adamvotocek/Open-Tube-Light/Code/Open-Tube-Light/DocumentationPics/20260207MPUBaseRegion0.png

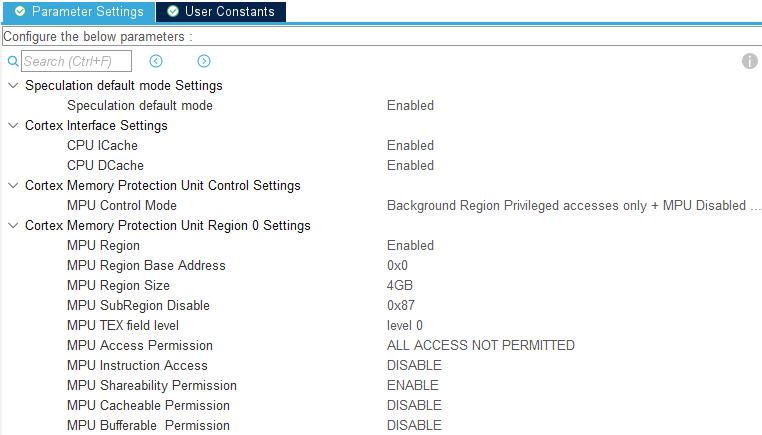
Code/Open-Tube-Light/DocumentationPics/20260207MPUBaseRegion0.png
