adamvotocek/Open-Tube-Light/PCB/ledTubeFixture/ledTubeFixture3Dmodel.step

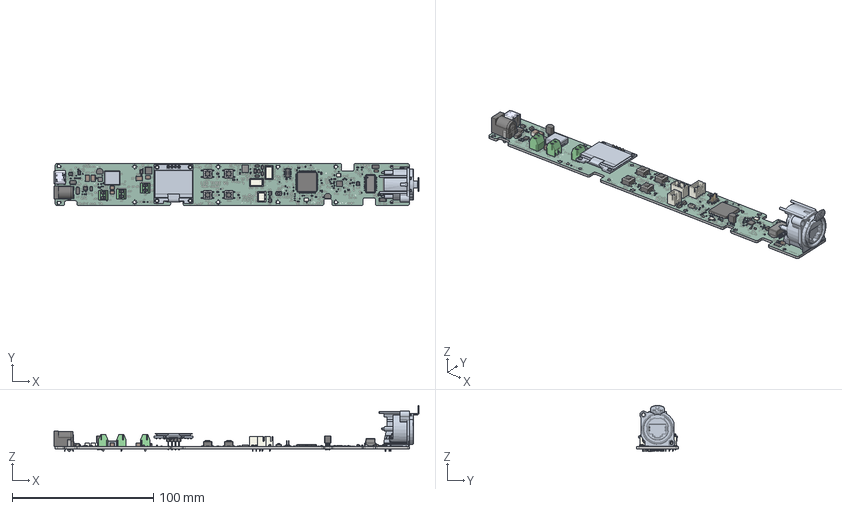
[picture p3: CAD file, 2026-05-30]
PCB/ledTubeFixture/ledTubeFixture3Dmodel.step
258.1 x 30.0 x 32.7 mm
D_SMA x 2
SOT-23-6 x 3
R_0603_1608Metric x 8
SW_SPST_PTS645Sx43SMTR92 x 4
R_0402_1005Metric x 47
C_0402_1005Metric x 45
LED_0603_1608Metric x 5
Crystal_SMD_3225-4Pin_3.2x2.5mm x 2
TO-92_Inline x 2
PT61018PEL
SOT-23-5 x 2
PinHeader_2x05_P1.27mm_Vertical_SMD
TPS56637RPAR--3DModel-STEP-56544
C_1210_3225Metric x 3
C_0603_1608Metric x 9
SW_Push_SPST_NO_Alps_SKRK
Texas_RGE0024H_VQFN-24-1EP_4x4mm_P0.5mm_EP2.7x2.7mm
L_APV_ANR5020
D_SOD-123F x 3
R_2010_5025Metric x 2
C_1812_4532Metric x 3
2445P Screw Terminal Block- 2 Pin, 3.5mm Pitch, Side Entry x 3
BarrelJack_GCT_DCJ200-10-A_Horizontal
ledTubeFixture3Dmodel 1.84.1
CA-IS2092A
JST_XH_B3B-XH-A_1x03_P2.50mm_Vertical x 2
R_1206_3216Metric x 4
JST_XH_B2B-XH-A_1x02_P2.50mm_Vertical
LQFP-100_14x14mm_P0.5mm
PDFN3333 (DFN8 3.3x3.3)
30012225_-_NE8FAH
C_1206_3216Metric x 2
TSOT-23-6
PinHeader_1x04_P2.54mm_Vertical
ledTubeFixture3Dmodel 1.167.1
ledTubeFixture_silkscreen
ledTubeFixture_soldermask x 2
ledTubeFixture_PCB
