adamvotocek/Open-Tube-Light/PCB/xlrConBoards/xlrConBoards.step

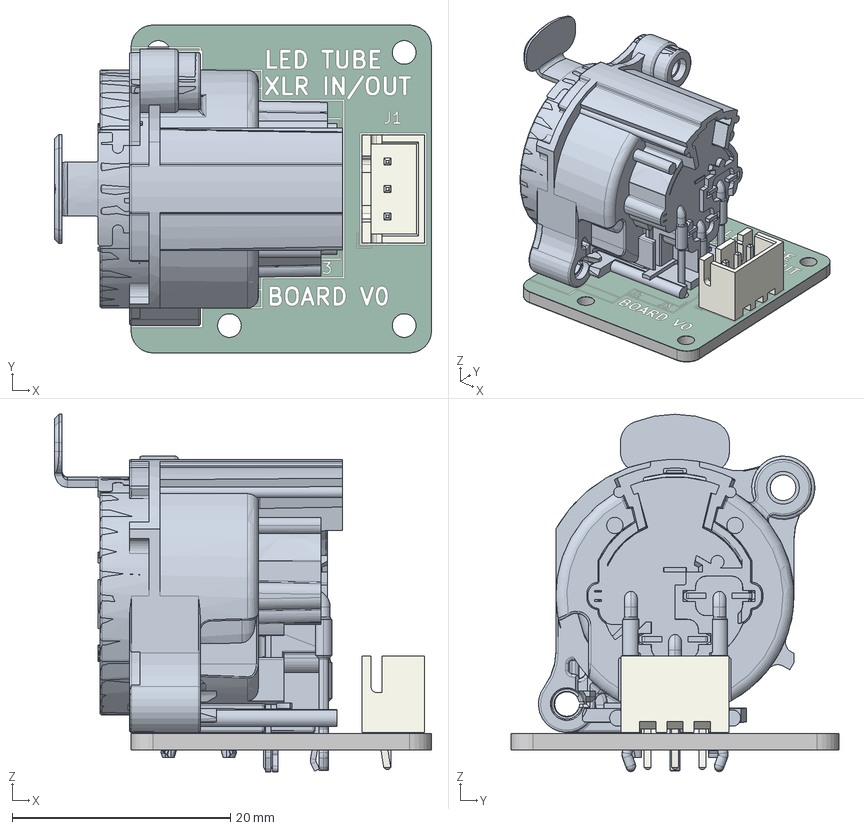
[picture p4: CAD file, 2026-05-30]
PCB/xlrConBoards/xlrConBoards.step
34.5 x 30.0 x 32.7 mm
JST_XH_B3B-XH-A_1x03_P2.50mm_Vertical
NC3FAAH
3D Model NC3MAAH-0
xlrConBoards_silkscreen
xlrConBoards_soldermask x 2
xlrConBoards_PCB
