adamvotocek/Open-Tube-Light/PCB/ledTubeFixture/ledTubeFixture.kicad_pcb

## KiCad design PCB/ledTubeFixture/ledTubeFixture.kicad_pcb (2026-11-11)

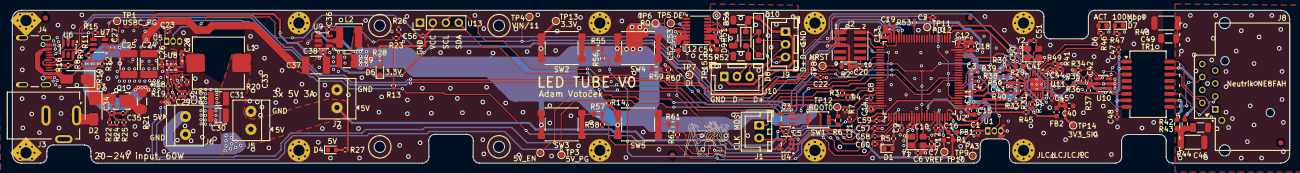
[picture p5: board ledTubeFixture.kicad_pcb from above]

Board: 4 copper layers, 250.8 x 30.0 mm, 200 parts (0 on the bottom side), 108 nets.

Parts:
C1, C8, C10, C11, C12, C13, C14, C20, C21, C22, C23, C28, C36, C42, C43, C44, C45, C47, C48, C57, C58, C59, C60: 100nF; C_0402_1005Metric
C2, C3, C4, C29, C33, C35: 10nF; C_0402_1005Metric
C5, C9, C16, C17, C27, C53, C54, C56: 1uF; C_0402_1005Metric
C6, C7, C50, C51: 12pF; C_0402_1005Metric
C15, C18, C19, C40, C41, C52, C55: 10uF; C_0603_1608Metric
C24, C25, C37: 22uF 50V; C_1812_4532Metric
C26, C34, C38: 100nF 50V; C_0402_1005Metric
C30, C31, C39: 47uF; C_1210_3225Metric
C32: 150pF; C_0402_1005Metric
C46, C49: 1nF 2kV; C_1206_3216Metric
D1, D4, D5, D6, D7: Red; LED_0603_1608Metric
D2, D3: ST34; D_SMA
D8, D9, D10: SMF12CA; D_SOD-123F
FB1, FB2: 600Ω@100MHz 450mΩ; C_0603_1608Metric
FID1, FID2, FID3, FID4: Fiducial_1mm; Fiducial_1mm_Mask2mm
H1, H2, H3, H4, H5, H6, H7, H8, H9, H10: M2; MountingHole_2.2mm_M2_Pad_Via
H11, H12: M2; MountingHole_2.2mm_M2
J1: JST_XH_2P; JST_XH_B2B-XH-A_1x02_P2.50mm_Vertical
J2: PZ127VS-12-10-H10-A38
J3: DC-005-A200; BarrelJack_DC-005-A200_Horizontal
J4: USB_C_Receptacle_USB2.0_16P_Tall_5.9mm; USB_C_Receptacle_HX_TYPE-C_16P+4.3
J5, J6, J7: DB301V-3.5-2P-GN-S; TerminalBlock_4Ucon_1x02_P3.50mm_Horizontal
J8: NE8FAH; NEUTRIK_NE8FAH
J9, J10: JST_XH_3P; JST_XH_B3B-XH-A_1x03_P2.50mm_Vertical
L1: 3.3uH 9mΩ 17A; MDA1050-3R3M
L2: 3.9uH 2.7A; L_APV_ANR5020
NT1: NetTie_2; NetTie-2_SMD_Pad0.5mm
Q1: SP40P18NJ; PDFN3X3-8L
R1: 0R; R_0603_1608Metric_Pad0.98x0.95mm_HandSolder
R2, R6, R42, R43, R55, R57, R59, R61: 75R; R_0603_1608Metric
R3, R4, R5, R19, R28, R33, R46, R47: 1.5k; R_0402_1005Metric
R7, R20, R29, R30, R31, R32, R49, R50, R53, R56, R58, R60, R62: 10k; R_0402_1005Metric
R8, R9, R10, R12, R15, R16, R26, R27: 5.1kΩ; R_0402_1005Metric
R11, R22, R24, R25: 200kΩ; R_0402_1005Metric
R13, R14, R17: 73.2k; R_0402_1005Metric
R18, R23: 51k; R_0402_1005Metric
R21: 0R 1206; R_1206_3216Metric_Pad1.30x1.75mm_HandSolder
R34, R35, R36, R37: 49.9R; R_0402_1005Metric
R38, R39, R40, R45: 33R; R_0402_1005Metric
R41: 12.1k; R_0402_1005Metric
R44, R48: 1M 2kV; R_2010_5025Metric
R51, R52, R54: 10R 250mW; R_1206_3216Metric
SW1: TS-1088-AR02016; SW_Push_SPST_NO_Alps_SKRK
SW2, SW3, SW4, SW5: Button; SW_SPST_4P_SMD
TP1, TP2, TP3, TP4, TP5, TP6, TP7, TP8, TP9, TP10, TP11, TP12, TP13, TP14, TP15: TestPoint; TestPoint_Pad_D1.0mm
TR1: B1601S; Transformer_Ethernet_B1601S
U1, U5: MCP9700A-E/TO; TO-92_Inline
U2: STM32H723VETx; LQFP-100_14x14mm_P0.5mm
U3, U4: SN74LVC1G17DBVR; SOT-23-5
U6, U10: SRV05-4; SOT-23-6
U7: CH221K; SOT-23-6
U8: TPS56A37; TPS56A37_10-pin_3x3mm_HotRod_QFN
U9: AP63203WU; TSOT-23-6
U11: LAN8742A; LAN8742A_VQFN-24-1EP_4x4mm_P0.5mm_EP2.5x2.5mm
U12: CA-IS2092A
U13: 0.96' OLED Board; HS96L03W2C03
Y1, Y2: 25 Mhz; Crystal_SMD_3225-4Pin_3.2x2.5mm

Connections:
3V3_SIG: C40.1, C42.1, C44.1, C45.1, C47.1, C48.1, FB2.2, R34.1, R35.1, R36.1, R37.1, TP14.1, TR1.2 (TDC), TR1.7 (RDC), U10.5 (VBUS), U11.1 (VDD2A), U11.19 (VDD1A)
5V_SK9822: C5.2, C30.1, C31.1, C32.1, J5.1, J6.1, J7.1, L1.2, R17.1, R27.1, U3.5 (VCC), U4.5 (VCC)
20-24V: C24.1, C25.1, C26.1, C37.1, C38.1, R21.2, R23.1, U8.8 (VIN), U9.2 (EN), U9.3 (IN)
+3V3: C9.1, C10.1, C11.1, C12.1, C13.1, C14.1, C15.1, C39.1, C43.1, C52.1, C53.1, C56.1, FB1.1, FB2.1, J2.1, L2.2, R3.1, R4.1, R13.2, R14.1, R28.1, R29.1, R30.1, R31.1, R32.1, R33.1, SW1.2, SW2.3 (K), SW2.4 (A), SW3.3 (K), SW3.4 (A), SW4.3 (K), SW4.4 (A), SW5.3 (K), SW5.4 (A), TP13.1, U2.6 (VBAT), U2.11 (VDD), U2.27 (VDD), U2.50 (VDD), U2.75 (VDD), U2.100 (VDD), U9.1 (FB), U11.9 (VDDIO), U12.6 (VDDP), U12.7 (VDDL), U13.2 (VCC)
/DMX/DE_nRE: R53.1, TP5.1, U2.65 (PC8), U12.2 (nRE), U12.3 (DE)
/DMX/DMX_N: D8.2 (A2), D10.2 (A2), J9.2, J10.2, R51.2
/DMX/DMX_P: D8.1 (A1), D9.2 (A2), J9.3, J10.3, R52.2
/DMX/GND_RS485: C54.2, C55.2, R54.2, U12.9 (GND2), U12.12 (GND2), U12.13 (SEL)
/DMX/PWR_RS485: C54.1, C55.1, TP15.1, U12.10 (VISO_IN), U12.11 (VISO_OUT)
/DMX/RS485_N: R51.1, U12.15 (B)
/DMX/RS485_P: R52.1, U12.14 (A)
/DMX/UART_DI: TP7.1, U2.80 (PC12), U12.4 (DI)
/DMX/UART_RO: TP6.1, U2.83 (PD2), U12.1 (RO)
/DisplayAndButtons/BUTTON_01: C57.1, R55.1, R56.1, U2.2 (PE3)
/DisplayAndButtons/BUTTON_02: C58.1, R57.1, R58.1, U2.3 (PE4)
/DisplayAndButtons/BUTTON_03: C59.1, R59.1, R60.1, U2.1 (PE2)
/DisplayAndButtons/BUTTON_04: C60.1, R61.1, R62.1, U2.4 (PE5)
/DisplayAndButtons/OLED_SCL: R3.2, U2.92 (PB6), U13.3 (SCL)
/DisplayAndButtons/OLED_SDA: R4.2, U2.93 (PB7), U13.4 (SDA)
/Ethernet/LED1_ANODE: D6.2 (A), R46.2
/Ethernet/LED2_ANODE: D7.2 (A), R47.2
/Ethernet/PHY_RMII_CRS_DV: R31.2, R40.2, U11.11 (CRS_DV/MODE2)
/Ethernet/PHY_RMII_REF_CLK: R32.2, R45.2, U11.14 (~INT/REFCLKO)
/Ethernet/PHY_RMII_RXD0: R29.2, R38.2, U11.8 (RXD0/MODE0)
/Ethernet/PHY_RMII_RXD1: R30.2, R39.2, U11.7 (RXD1/MODE1)
/Ethernet/RD_N: R37.2, TR1.8 (RD-), U10.6 (I/O4), U11.22 (RXN)
/Ethernet/RD_P: R36.2, TR1.6 (RD+), U10.1 (I/O1), U11.23 (RXP)
/Ethernet/RMII_CRS_DV: R40.1, U2.31 (PA7)
/Ethernet/RMII_MDC: U2.16 (PC1), U11.13 (MDC)
/Ethernet/RMII_MDIO: R33.2, U2.24 (PA2), U11.12 (MDIO)
/Ethernet/RMII_REF_CLK: R45.1, U2.23 (PA1)
/Ethernet/RMII_RXD0: R38.1, U2.32 (PC4)
/Ethernet/RMII_RXD1: R39.1, U2.33 (PC5)
/Ethernet/RMII_TXD0: U2.51 (PB12), U11.17 (TXD0)
/Ethernet/RMII_TXD1: U2.52 (PB13), U11.18 (TXD1)
/Ethernet/RMII_TXEN: U2.47 (PB11), U11.16 (TXEN)
/Ethernet/RXC: R42.1, TR1.10 (RXC)
/Ethernet/RX_N: J8.6 (RX-), TR1.9 (RX-)
/Ethernet/RX_P: J8.3 (RX+), TR1.11 (RX+)
/Ethernet/TD_N: R35.2, TR1.3 (TD-), U10.4 (I/O3), U11.20 (TXN)
/Ethernet/TD_P: R34.2, TR1.1 (TD+), U10.3 (I/O2), U11.21 (TXP)
/Ethernet/TXC: R43.1, TR1.15 (TXC)
/Ethernet/TX_N: J8.2 (TX-), TR1.14 (TX-)
/Ethernet/TX_P: J8.1 (TX+), TR1.16 (TX+)
/Ethernet/XTAL1: C50.1, U11.5 (XTAL1/CLKIN), Y2.1
/Ethernet/XTAL2: C51.1, U11.4 (XTAL2), Y2.3
/MCU/ADC1_INP3_VINSENSE: C2.1, R23.2, R26.1, TP4.1, U2.30 (PA6)
/MCU/ADC1_INP5_TEMP2: C4.1, U1.2 (V_{OUT}), U2.34 (PB0)
/MCU/ADC1_INP9_TEMP1: C3.1, U2.35 (PB1), U5.2 (V_{OUT})
/MCU/B0_BTN: R6.2, SW1.1
/MCU/BOOT0: C8.1, R6.1, R7.1, TP12.1, U2.94 (BOOT0)
/MCU/HSE_IN: C6.1, U2.12 (PH0), Y1.1
/MCU/HSE_OUT: C7.1, U2.13 (PH1), Y1.3
/MCU/LED_RED: R5.1, U2.5 (PE6)
/MCU/LED_RED_ANODE: D1.2 (A), R5.2
/MCU/NRST: C20.1, J2.10, TP8.1, U2.14 (NRST), U11.15 (~RST)
/MCU/PSU5V_PG_GPIO: C22.1, R14.2, TP3.1, U2.37 (PE7), U8.4 (PG)
/MCU/SPI1_MOSI: U2.88 (PD7), U3.2
/MCU/SPI1_SCK: U2.29 (PA5), U4.2
/MCU/SPI_SK9822_MOSI: J1.1, U3.4
/MCU/SPI_SK9822_SCK: J1.2, U4.4
/MCU/T_GNDDETECT: J2.9, R2.1
/MCU/T_SWCLK: J2.4, U2.76 (PA14(JTCK)
/MCU/T_SWDIO: J2.2, U2.72 (PA13(JTMS)
/MCU/T_SWO: J2.6, U2.89 (PB3(JTDO)
/MCU/USBC_PG_GPIO: C21.1, R13.1, TP1.1, U2.98 (PE1), U7.3 (PG)
/Power/5V_ENABLE: C29.1, TP2.1, U2.38 (PE8), U8.1 (EN)
/Power/AP_BST: C36.1, U9.6 (BST)
/Power/AP_SW: C36.2, L2.1, U9.5 (SW)
/Power/BC_VIN: D2.2 (A), J3.1
/Power/CC1: J4.A5 (CC1), R15.1, U7.4 (CC1)
/Power/CC2: J4.B5 (CC2), R16.1, U7.5 (CC2)
/Power/CH_CFG: R11.2, U7.6 (CFG)
/Power/CH_VDD: C27.1, R8.2, R9.2, R10.2, R11.1, R12.2, U7.1 (VDD)
/Power/LED_3V3PWR_ANODE: D5.2 (A), R28.2
/Power/LED_5VPWR_ANODE: D4.2 (A), R27.2
/Power/PM_D: C35.1, Q1.3 (D), R21.1
/Power/PM_G: C34.2, C35.2, Q1.2 (G), R24.2, R25.1
/Power/TPS_BOOT: C28.1, U8.7 (BOOT)
/Power/TPS_FB: C32.2, R17.2, R20.1, U8.2 (FB)
/Power/TPS_MODE: R18.1, U8.10 (MODE)
/Power/TPS_SS: C33.1, U8.5 (SS)
/Power/TPS_SW: C28.2, L1.1, U8.6 (SW)
/Power/USBC_D+: J4.A6 (D+), J4.B6 (D+), U2.71 (PA12), U6.6 (I/O4)
/Power/USBC_D-: J4.A7 (D-), J4.B7 (D-), U2.70 (PA11), U6.4 (I/O3)
/Power/USBC_VIN: D3.2 (A), J4.A4 (VBUS), J4.A9 (VBUS), J4.B4 (VBUS), J4.B9 (VBUS), R8.1, R9.1, R10.1, R12.1
AGND_BUCK: C29.2, C33.2, NT1.1, R19.2, R20.2, U8.3 (AGND)
GND: C1.2, C2.2, C3.2, C4.2, C5.1, C6.2, C7.2, C8.2, C9.2, C10.2, C11.2, C12.2, C13.2, C14.2, C15.2, C16.2, C17.2, C18.2, C19.2, C20.2, C21.2, C22.2, C23.2, C24.2, C25.2, C26.2, C27.2, C30.2, C31.2, C37.2, C38.2, C39.2, C40.2, C41.1, C42.2, C43.2, C44.2, C45.2, C47.2, C48.2, C49.1, C50.2, C51.2, C52.2, C53.2, C56.2, C57.2, C58.2, C59.2, C60.2, D1.1 (K), D4.1 (K), D5.1 (K), D6.1 (K), D7.1 (K), H1.1, H2.1, H3.1, H4.1, H5.1, H6.1, H7.1, H8.1, H9.1, H10.1, J2.3, J2.5, J3.2, J4.A1 (GND), J4.A12 (GND), J4.B1 (GND), J4.B12 (GND), J5.2, J6.2, J7.2, NT1.2, R2.2, R7.2, R15.2, R16.2, R25.2, R26.2, R41.2, R48.2, R49.2, R50.2, R53.2, R56.2, R58.2, R60.2, R62.2, U1.3 (GND), U2.10 (VSS), U2.19 (VSSA), U2.26 (VSS), U2.49 (VSS), U2.74 (VSS), U2.99 (VSS), U3.3 (GND), U4.3 (GND), U5.3 (GND), U6.2 (GND), U7.2 (GND), U8.9 (PGND), U9.4 (GND), U10.2 (GND), U11.25 (VSS), U12.5 (GND1), U12.8 (GND1), U13.1 (GND), Y1.2 (GND), Y1.4 (GND), Y2.2 (GND), Y2.4 (GND)
GND_DMX: D9.1 (A1), D10.1 (A1), J9.1, J10.1, R54.1
unnamed: C46.1, R42.2, R43.2, R44.1
unnamed: R18.2, R19.1
unnamed: R22.2, R24.1
unnamed: R55.2, SW2.1, SW2.2
unnamed: R57.2, SW3.1, SW3.2
unnamed: R59.2, SW4.1, SW4.2
unnamed: R61.2, SW5.1, SW5.2
unnamed: TP9.1, U2.25 (PA3)
unnamed: TP11.1, U2.59 (PD12)
unnamed: R46.1, U11.3 (LED1/REGOFF)
unnamed: R47.1, R49.1, U11.2 (LED2/~INTSEL)
unnamed: R41.1, U11.24 (RBIAS)
unnamed: R50.1, U11.10 (RXER/PHYAD0)
unnamed: C41.2, U11.6 (VDDCR)
SH_GND: C46.2, C49.2, J8.G, R44.2, R48.1
VCAP_MCU: C18.1, C19.1, U2.48 (VCAP), U2.73 (VCAP)
VDDA_MCU: C1.1, C16.1, C23.1, FB1.2, R1.1, U1.1 (V_{DD}), U2.21 (VDDA), U5.1 (V_{DD})
VIN: C34.1, D2.1 (K), D3.1 (K), Q1.1 (S), R22.1
VREF+: C17.1, R1.2, TP10.1, U2.20 (VREF+)
