adamvotocek/Open-Tube-Light/PCB/xlrConBoards/xlrConBoards.kicad_pcb

## KiCad design PCB/xlrConBoards/xlrConBoards.kicad_pcb (2026-01-23)

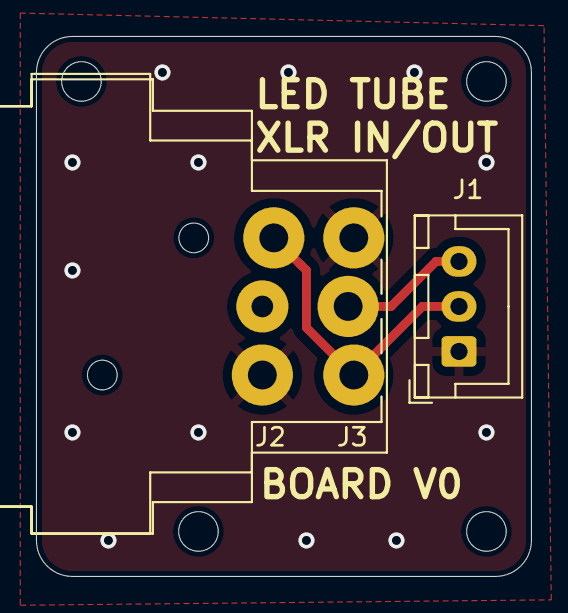
[picture p6: board xlrConBoards.kicad_pcb from above]

Board: 2 copper layers, 27.5 x 30.0 mm, 7 parts (0 on the bottom side), 2 nets.

Parts:
H1, H2, H3, H4: M2; MountingHole_2.2mm_M2
J1: JST_XH_3P; JST_XH_B3B-XH-A_1x03_P2.50mm_Vertical
J2: NC3FAAH; Neutrik_NC3FAAH
J3: NC3MAAH-0; Neutrik_NC3MAAH-0

Connections:
/DMX_D-: J1.2, J2.2, J3.2
/DMX_GND: J1.1, J2.1, J3.1
