adamvotocek/Open-Tube-Light/Code/Open-Tube-Light/Open-Tube-Light.ioc

Mcu.UserName=STM32H723VETx
PA1.Signal=ETH_REF_CLK
PA13(JTMS/SWDIO).Signal=DEBUG_JTMS-SWDIO
PA14(JTCK/SWCLK).Signal=DEBUG_JTCK-SWCLK
PA2.Signal=ETH_MDIO
PA5.Signal=SPI1_SCK
PA7.Signal=ETH_CRS_DV
PB11.Signal=ETH_TX_EN
PB12.Signal=ETH_TXD0
PB13.Signal=ETH_TXD1
PB3(JTDO/TRACESWO).Signal=DEBUG_JTDO-SWO
PB6.Signal=I2C1_SCL
PB7.Signal=I2C1_SDA
PC1.Signal=ETH_MDC
PC12.Signal=UART5_TX
PC4.Signal=ETH_RXD0
PC5.Signal=ETH_RXD1
PC8.Signal=UART5_DE
PD2.Signal=UART5_RX
PD7.Signal=SPI1_MOSI
PE1.GPIO_Label=USBC_PG
PE1.Signal=GPIO_Input
PE2.GPIO_Label=BUTTON3
PE2.Signal=GPIO_Input
PE3.GPIO_Label=BUTTON1
PE3.Signal=GPIO_Input
PE4.GPIO_Label=BUTTON2
PE4.Signal=GPIO_Input
PE5.GPIO_Label=BUTTON4
PE5.Signal=GPIO_Input
PE6.GPIO_Label=LED_RED
PE6.Signal=GPIO_Output
PE7.GPIO_Label=PSU_5V_PG
PE7.Signal=GPIO_Input
PE8.GPIO_Label=PSU_5V_EN
PE8.Signal=GPIO_Output
PH0-OSC_IN.Signal=RCC_OSC_IN
PH1-OSC_OUT.Signal=RCC_OSC_OUT
