adamvotocek/Open-Tube-Light/Code/Open-Tube-Light/Core/Inc/Art-Net/artnet.h

/**
 * @file artnet.h
 * @brief Art-Net 4 Protocol Handler for STM32H7 - Public API
 * 
 * Public interface for the Art-Net implementation. Supports Art-Net 4 with
 * per-universe OpSync for tear-free LED updates in multi-controller
 * environments. Uses double-buffering (shadow/active) for atomic updates.
 * 
 * @see artnet_protocol.h for Art-Net protocol structures and constants
 * @see device_config.h for configuration management
 */

#ifndef INC_ARTNET_H_
#define INC_ARTNET_H_

#include "artnet_protocol.h"
#include "Device-Config/device_config.h"
#include "cmsis_os.h"
#include "lwip/ip_addr.h"
#include <stdint.h>
#include <stdbool.h>

#ifdef __cplusplus
extern "C" {
#endif

/* ========================== Public Types ========================== */

/**
 * @brief Per-universe Art-Net state
 * 
 * Each universe independently tracks its source controller, timing, and
 * sync mode. This enables multi-controller operation where different
 * controllers drive different universes on the same node, each with
 * independent sync behavior.
 */
typedef struct {
    ip_addr_t  source_ip;       ///< Source controller IP (0.0.0.0 = unassigned, first-source-wins)
    uint32_t   last_dmx_tick;   ///< Timestamp of last ArtDmx for disconnect detection
    uint8_t    last_sequence;   ///< Last ArtDmx sequence number (0 = no sequenced packet yet)
    bool       sync_mode;       ///< True when this universe's controller is sending ArtSync
    uint32_t   last_sync_tick;  ///< Timestamp of last ArtSync from this universe's controller
} ArtNet_UniverseState_t;

/* ========================== Public API Functions ========================== */

/**
 * @brief Initialize the Art-Net receiver
 * 
 * Must be called once during system initialization, after LwIP is up.
 * Configuration is read from device_config module.
 * 
 * @param processing_task_handle RTOS task handle to notify on new data
 * @return 0 on success, -1 on failure
 * 
 * @note Call after tcpip_init() from a task, never from tcpip_thread: the
 *       UDP PCB is set up under the LwIP core lock (LOCK_TCPIP_CORE).
 * @note DeviceConfig_Init() must be called before this function
 */
int ArtNet_Init(osThreadId_t processing_task_handle);

/**
 * @brief Tear down the Art-Net receiver and release all resources
 * 
 * Removes the UDP PCB, deletes the timer and mutex, zeros buffers,
 * and clears the initialized flag. Safe to call when not initialized.
 * After deinit, ArtNet_Init() can be called again.
 *
 * @note Same context rule as ArtNet_Init(). EffectTask must not be inside
 *       ArtNet_LatchData() while this runs (the shadow mutex is deleted), so
 *       runtime input switching needs EffectTask quiesced first.
 */
void ArtNet_Deinit(void);

/**
 * @brief Get pointer to the active DMX buffer for a specific universe
 * 
 * @param universe Universe index (0 to configured universe count - 1)
 * @return Pointer to 512-byte DMX buffer, or NULL if universe index invalid
 * 
 * @note Buffer is read-only and stable until the next ArtNet_LatchData() call
 */
const uint8_t* ArtNet_GetUniverseData(uint8_t universe);

/**
 * @brief Latch shadow buffer to active buffer
 * 
 * Copies the configured universes' shadow buffers to the active buffers so the rendering task
 * sees a coherent snapshot. Call from the processing task after being
 * notified via thread flags.
 */
void ArtNet_LatchData(void);

#ifdef __cplusplus
}
#endif

#endif /* INC_ARTNET_H_ */
