adamvotocek/Open-Tube-Light/(commit log)

2026-01-23 add STM32CubeIDE project
2026-01-23 Added KiCAD PCB project
2026-02-07 added gitignore for kicad stuff
2026-02-09 imported simple sk9866 driver
2026-02-15 fixed wrong spi buffer handling, fixed wrong MAC, relentless refactoring
2026-02-24 complete artnet refactor, added device config and partly implemented
2026-02-25 chore: migrate toolchain from STM32CubeIDE to STM32CubeVSCode + CMake
    - Switched build system from STM32CubeIDE Makefiles to CMake (Ninja generator)
    - Replaced STM32H723VETX_FLASH.ld with CubeMX-generated STM32H723XX_FLASH.ld, ported custom memory layout: RAM_D1 split for LwIP (64KB non-cacheable), D2 DMA sections (.spi_buffers, .RxDecripSection, .TxDecripSection), DTCM DMX buffers, and added linker ASSERT overflow guards
    - Stack and data/bss now in DTCM (zero-wait-state) instead of AXI SRAM
    - Added .gitattributes to enforce LF line endings repo-wide
    - Added .vscode/ workspace config, .clangd, CMakePresets.json
2026-02-25 Remove unnecessary project files and duplicate startup assembly code for STM32H723xx
2026-03-11 migrated STM32Cube FW_H7 to version 1.13.0
2026-03-11 Add UART5 support for future DMX recieve and transmit
2026-03-12 Add pixel rendering module and integrate with SK9822 driver for DMX data handling
2026-03-17 Implement DMX512 UART input driver with DMA support and update configuration. Mostly works, but has bugs in multiple edge cases.
2026-03-17 Refactor DMX512 UART driver to use lock-free double-buffering for ISR and EffectTask synchronization, replacing mutex with pending buffers for improved performance and safety.
2026-03-17 Refactor DMX512 UART packet processing to streamline ISR handling and improve code clarity by extracting packet processing logic into a dedicated function.
2026-03-18 Refactor DMX512 UART handling. UART ISR now has a priority of 3 and notifies the EffectTask via another IRQ, which has a priority of 5 (deffered notification)
2026-03-18 Update UART5 configuration to use 1 stop bit for improved communication reliability with transmitters that don't follow the DMX spec very well
2026-03-18 small refactor and add inter-slot IDLE sensitivity note
2026-03-18 refactor DMX512 UART
2026-03-19 refactor: consolidate DMX512 UART state management into a context structure
2026-05-16 kicad files minor updates
2026-05-17 enhance device configuration management with partial updates and better validation
2026-05-18 edit schematic note
2026-05-18 configured i2c for the oled via cubemx
2026-05-19 added base OLED library fromafiskon/stm32-ssd1306
2026-05-19 add DMA and RTOS functionality to the OLED library
2026-05-19 enabled i2c interrupts and made a working OLED demo
2026-06-09 set led strip SPI MasterKeepIOState to true. it makes the line less prone to bugs due to noise, but really doesn't change much
2026-06-09 updated list of problems with the current version
2026-11-09 update device configuration to set segment count to 144 and initialize static IP addresses without DHCP
2026-11-11 Clean up tracked files and consolidate ignore rules
    - Untrack 43 files that matched ignore rules (KiCad backups, fp-info-cache,
    .kicad_prl, *-bak, production/backups). They stay on disk.
    - Delete duplicate top-level release zips (identical copies in PCB/releases/).
    - Root .gitignore now only holds repo-wide junk; firmware-only rules (docs/
    reference and plans, workspace file, .claude/settings.local.json) moved
    to Code/Open-Tube-Light/.gitignore; drop blanket *.pdf.
    - PCB/.gitignore: add *.kicad_sch-bak, *.lck, **/production/backups/.
    - Move .gitattributes to the repo root and mark zip/pdf/step/stp as binary.
2026-11-11 Remove STM32CubeIDE leftovers
    Delete the tracked CubeIDE launch config (.vscode/launch.json covers
    ST-Link debugging) and drop ignore rules for Makefile build dirs that
    CMake never produces. Keep ignoring .settings/ (STM32Cube VS Code
    extension state), .mxproject, .project and .cproject.
2026-11-12 Add stack monitor, product identity constants, per-unit MAC
    - Stack-Monitor module: per-task stack and heap high-water marks at 1 Hz,
    overflow hook records the failing task before halting
    - Replace snprintf in ArtPollReply NodeReport with a bounded formatter
    - Product identity constants (fw version, HW rev, OEM/ESTA) in device_config.h
    - Derive per-unit MAC from MCU UID instead of shared CubeMX address
    - Mark DHCP/direct-link network issue solved (static IP)
    - CLAUDE.md: placement rule to pick the cleanest owner before coding
2026-11-13 Docs: locate via ArtAddress, RDM as planned replacement for OpenTubeDia
    - Drop the custom ArtTrigger KeyWink locate; locate uses ArtAddress
    AcLedLocate (tube flash). OLED corner dot and AcLedMute move to the
    planned OLED menu system
    - Mark the OpenTubeDia custom protocol (NodeReport fields, ArtCommand
    verbs) as transitional; RDM over Art-Net will replace it
    - Compliance matrix: colour markers for Status and Implement? columns
    with a legend, RDM rows marked planned (new infrastructure item 11.12),
    suggested order updated
    - Roadmap: menu system with display timeout, locate, RDM responder
2026-11-14 Track bench test in tools/, untrack only copyrighted references
    - Move the Art-Net bench script from the untracked Temporary_Tests/ folder
    to Code/Open-Tube-Light/tools/artnet_bench_test.py and keep extending it
    per feature (it was artnet_quickwins_test.py)
    - Temporary_Tests/ renamed to Temp_Scenes/ (Lightkey / QLC+ scenes),
    still ignored
    - Stop ignoring docs/plans/ so design decisions are versioned; only
    docs/reference/ (copyrighted specs) stays local
    - Ignore __pycache__/
2026-11-14 Art-Net robustness fixes from the audit
    - ArtNet_Init/Deinit hold LOCK_TCPIP_CORE() around udp_new/bind/recv/remove
    and the tcpip-owned state they reset (they called raw LwIP from
    ControlTask without the lock)
    - Seed the ArtPollReply delay PRNG per unit (boot tick mixed with the
    UID-derived MAC), so fixtures powered up together don't reply in sync
    - Poll reply can no longer wedge: drop the queue if osTimerStart fails,
    retry after 10 ms if tcpip_callback fails
    - Drop chained pbufs in the UDP callback (handlers read p->payload as one
    contiguous packet)
    - Named minimum lengths with offsetof static asserts instead of bare
    18/14/18; ARTNET_FAILSAFE_TIMEOUT_MS with a static assert agai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
2026-11-14 device_config: drop unused Art-Net helper, fix stale comments
    - Remove DeviceConfig_BuildArtNetOutputAddressList() (no callers); it was
    the only reason device_config.c included an Art-Net header
    - Rewrite comments that described flash storage, callbacks and a CRC32
    that don't exist; document what is actually stubbed
2026-11-14 Docs: track plans, audit follow-ups, network before RDM
    - docs/plans/ now tracked; new artnet-audit-followups.md lists the open
    audit findings (control-plane split, reply slots, parser split,
    robustness, host-side tests, flash erase stall) with a slot for each
    - Order: network configuration now comes before RDM (compliance §12,
    roadmap); control plane always-on recommended before the config service
    - device-config-refactor.md gets a status table (phases 2-3 superseded,
    persistence open); config-commits plan, memory-tuning and the completed
    quick-wins plan brought up to date
    - issues.md: current 2.x default IP; dmx-input-drivers.md: shared flag,
    core-lock rule; README and CLAUDE.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
